NikolayShevyrev/Kicad_EVT_Connector/Datasheets/WhatsApp Image 2021-07-20 at 15.19.37.jpeg

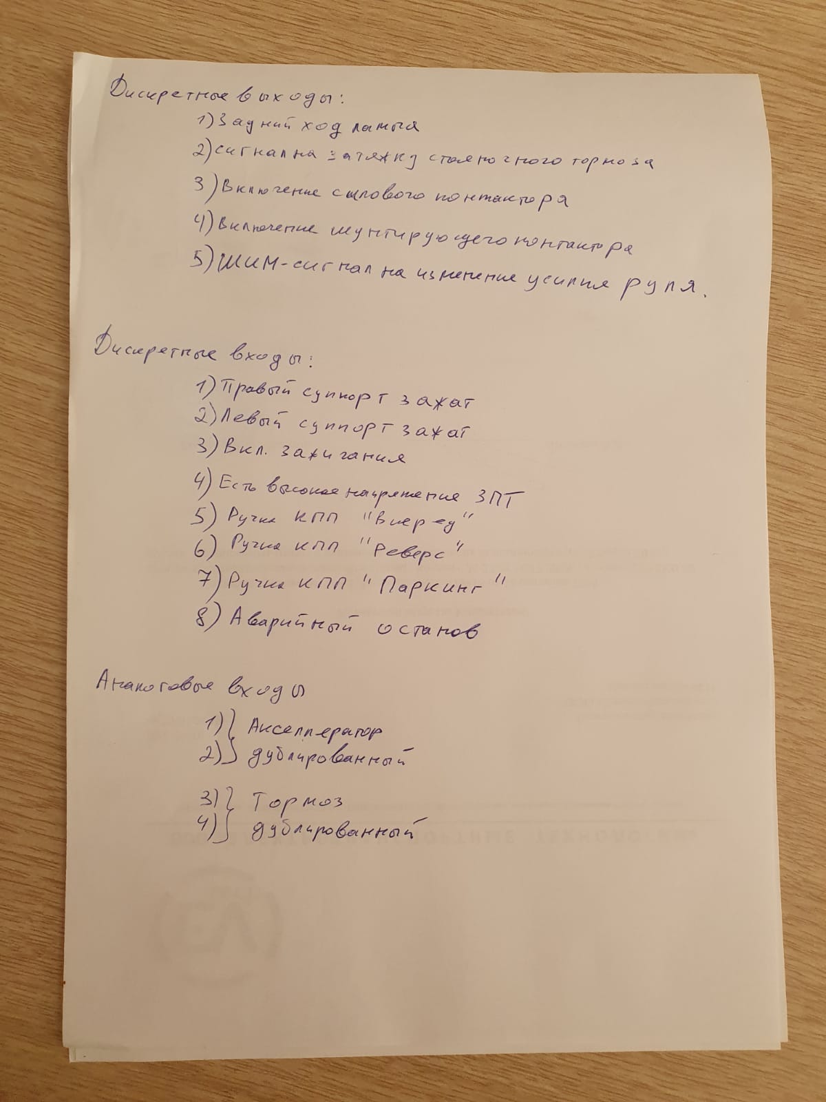
Datasheets/WhatsApp Image 2021-07-20 at 15.19.37.jpeg
