NikolayShevyrev/Kicad_EVT_Connector/Datasheets/WhatsApp Image 2021-07-19 at 15.48.50.jpeg

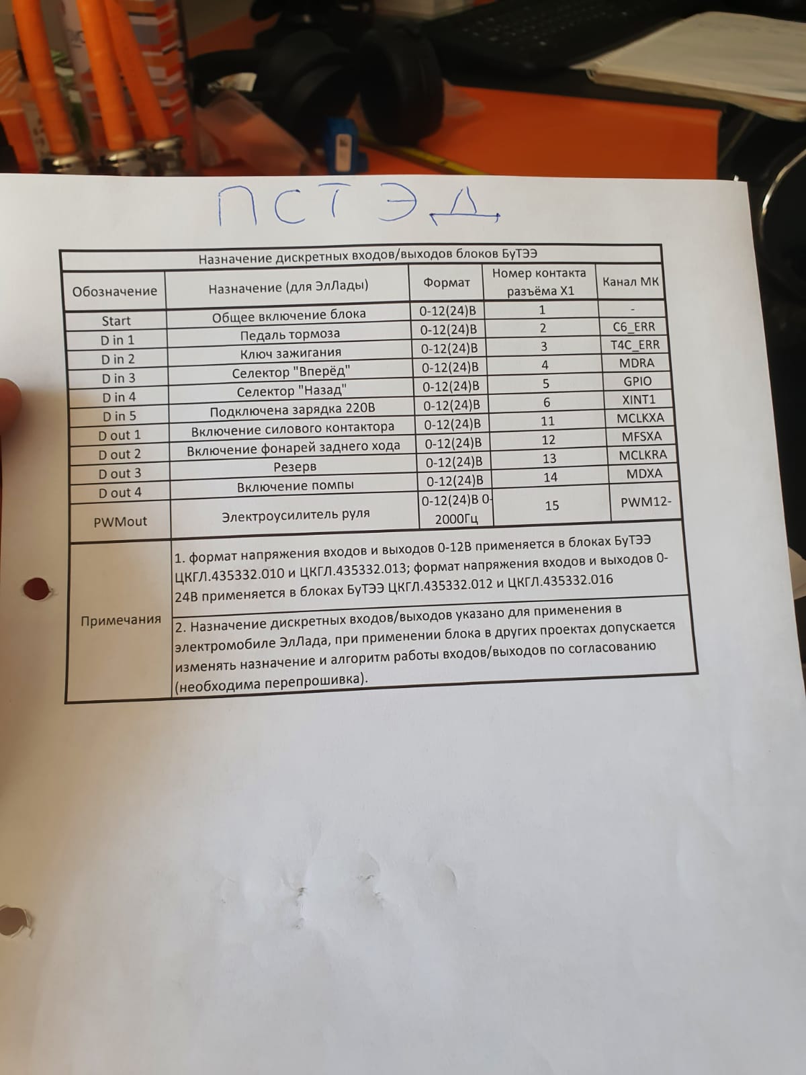
Datasheets/WhatsApp Image 2021-07-19 at 15.48.50.jpeg
