NikolayShevyrev/Kicad_EVT_Connector/Datasheets/WhatsApp Image 2021-07-19 at 15.48.51.jpeg

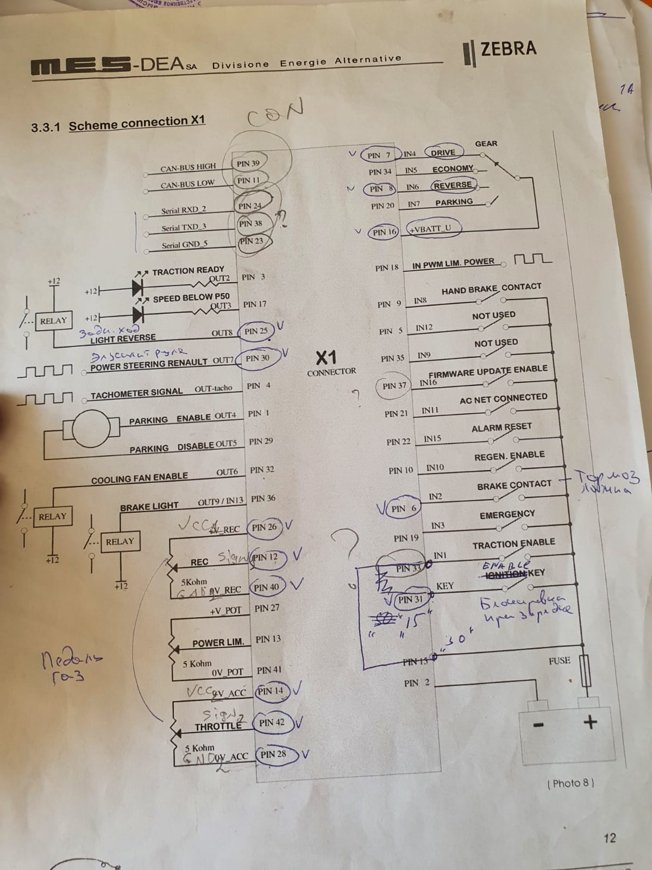
Datasheets/WhatsApp Image 2021-07-19 at 15.48.51.jpeg
