NikolayShevyrev/Kicad_EVT_Connector/Manufacturing/Спецификация.xls

Позиционное обозначение (RefDes)* | Номинал (Value)* | Тип корпуса (Package)* | Кол-во (Quantity)* | Наименование (PartNumber) | Производитель (Manufacturer) | Описание (Description) | Возможная замена/примечание
J1 | 776163-1 | Вилка на плату | 1 | 776163-1
J2 J5 | 43045-1000 | Вилка на плату 3 мм 2x5 | 2 | 43045-1000
J3 J4 | 43045-0800 | Вилка на плату 3 мм 2x4 | 2 | 43045-0800
