NikolayShevyrev/Kicad_EVT_Connector/Manufacturing/Connector_RevB.pdf

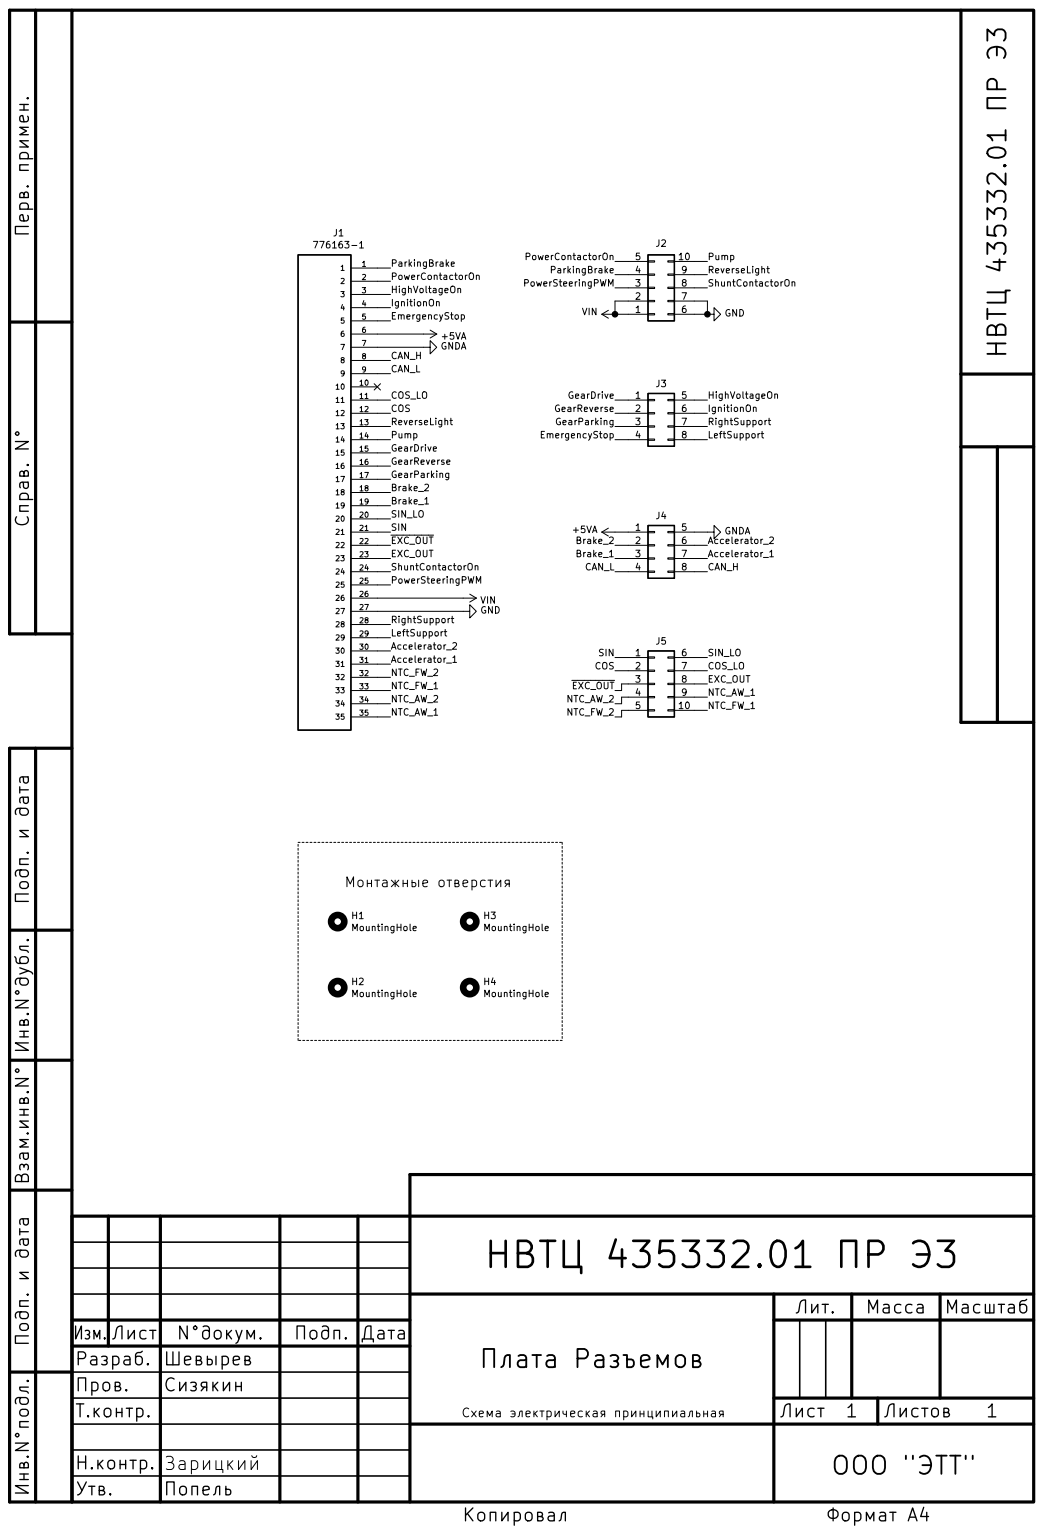
[picture p5: page 1]
