NikolayShevyrev/Kicad_EVT_Connector/Manufacturing/Монтажная_Схема.pdf

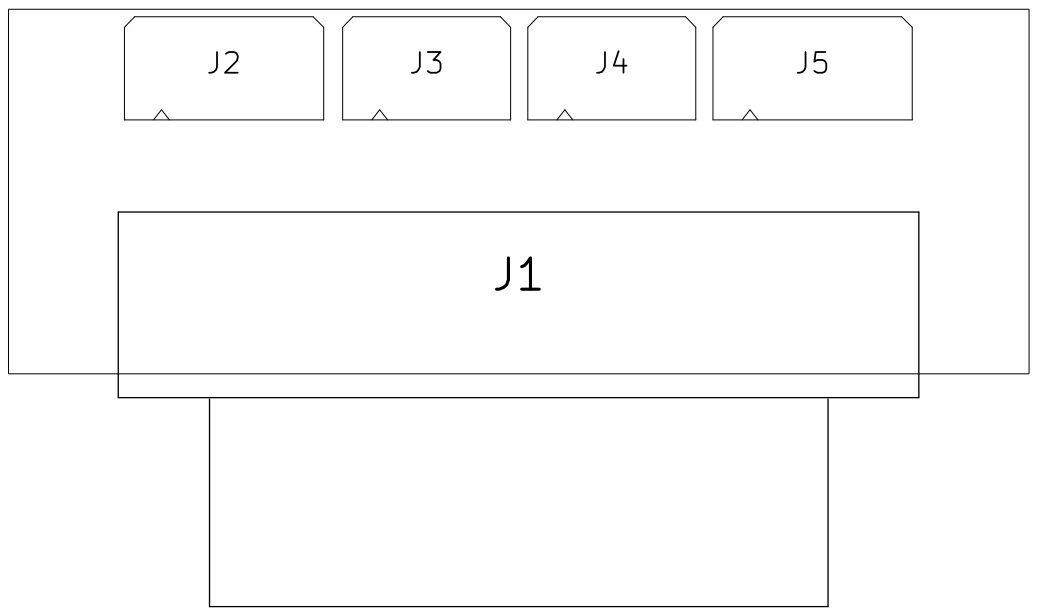
[picture p6: page 1]
