NikolayShevyrev/Kicad_EVT_Connector/Connector.kicad_pcb

## KiCad design Connector.kicad_pcb (2023-03-20)

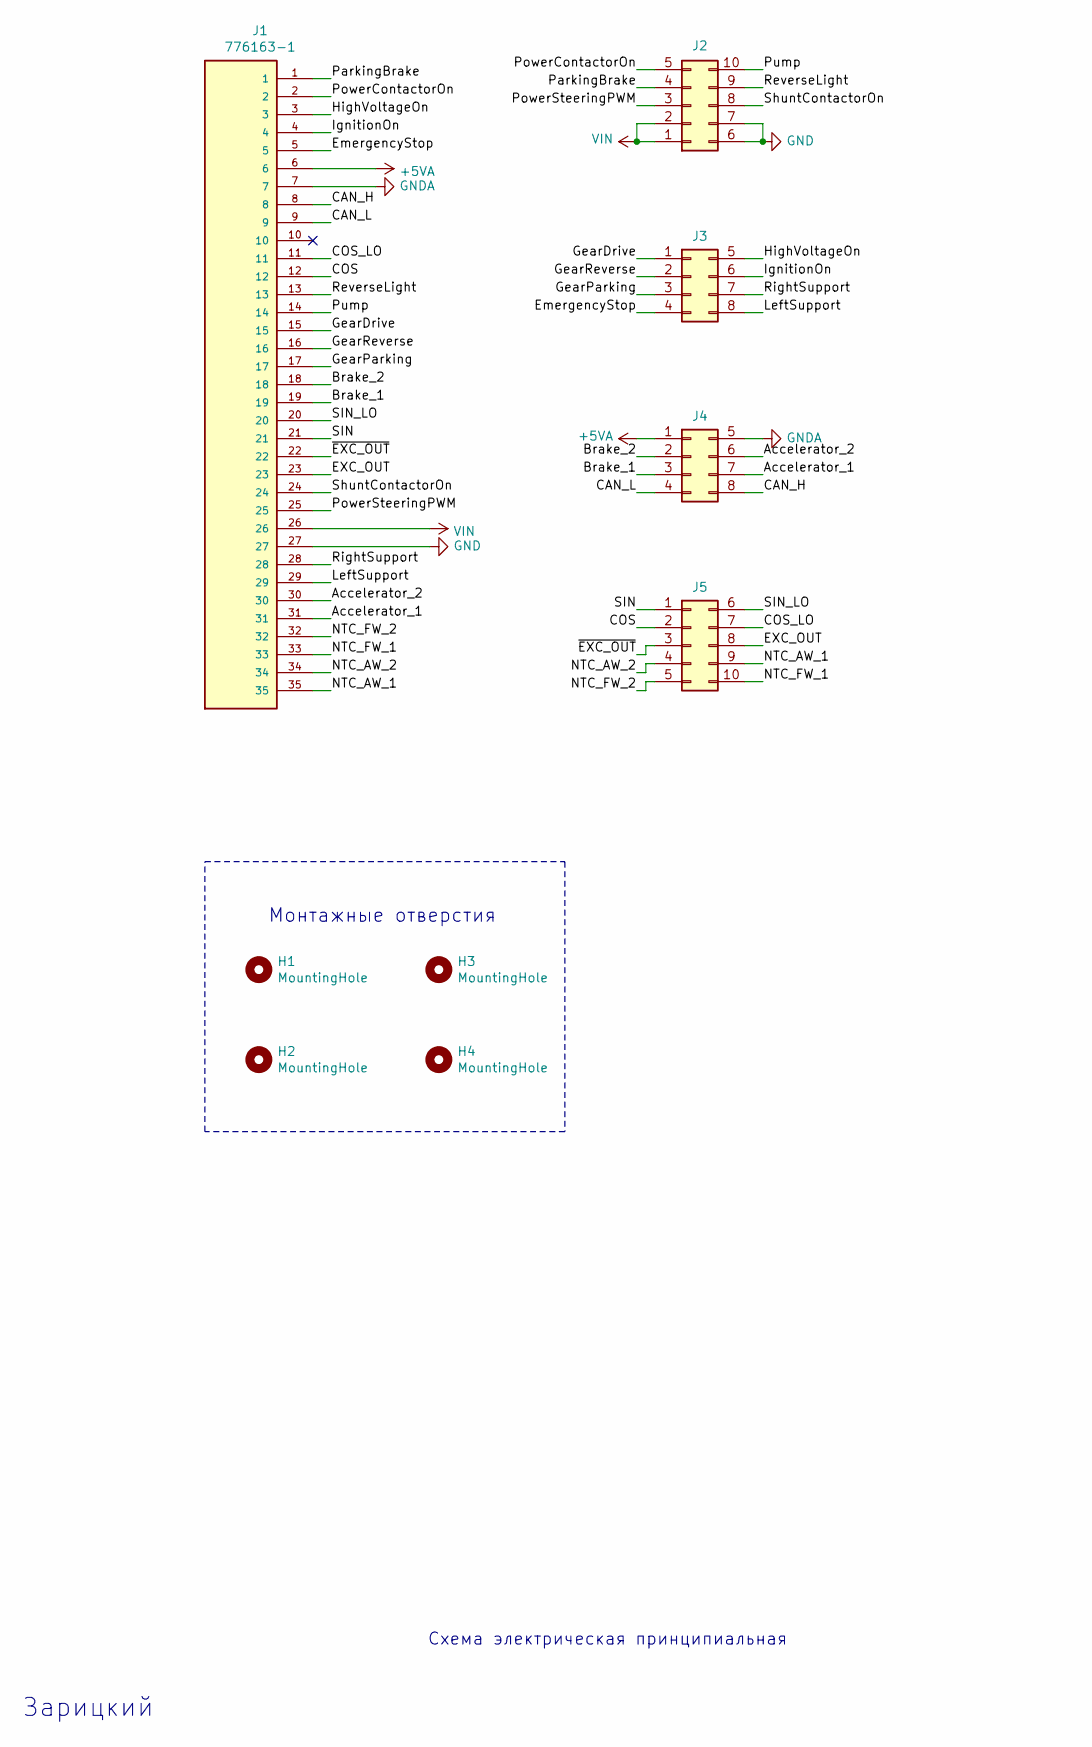
[picture p7: schematic Connector.sch, Плата Разъемов]

Parts:
H1, H2, H3, H4: MountingHole; MountingHole_4.5mm
J1: 776163-1; TE_776163-1
J2, J5: Conn_02x05_Top_Bottom; Molex_Micro-Fit_3.0_43045-1000_2x05_P3.00mm_Horizontal
J3, J4: Conn_02x04_Top_Bottom; Molex_Micro-Fit_3.0_43045-0800_2x04_P3.00mm_Horizontal

Connections:
+5VA: J1.6, J4.1
/Accelerator_1: J1.31, J4.7
/Accelerator_2: J1.30, J4.6
/Brake_1: J1.19, J4.3
/Brake_2: J1.18, J4.2
/CAN_H: J1.8, J4.8
/CAN_L: J1.9, J4.4
/COS: J1.12, J5.2
/COS_LO: J1.11, J5.7
/EXC_OUT: J1.23, J5.8
/EmergencyStop: J1.5, J3.4
/GearDrive: J1.15, J3.1
/GearParking: J1.17, J3.3
/GearReverse: J1.16, J3.2
/HighVoltageOn: J1.3, J3.5
/IgnitionOn: J1.4, J3.6
/LeftSupport: J1.29, J3.8
/NTC_AW_1: J1.35, J5.9
/NTC_AW_2: J1.34, J5.4
/NTC_FW_1: J1.33, J5.10
/NTC_FW_2: J1.32, J5.5
/ParkingBrake: J1.1, J2.4
/PowerContactorOn: J1.2, J2.5
/PowerSteeringPWM: J1.25, J2.3
/Pump: J1.14, J2.10
/ReverseLight: J1.13, J2.9
/RightSupport: J1.28, J3.7
/SIN: J1.21, J5.1
/SIN_LO: J1.20, J5.6
/ShuntContactorOn: J1.24, J2.8
/~EXC_OUT: J1.22, J5.3
GND: J1.27, J2.6, J2.7
GNDA: J1.7, J4.5
VDD: J1.26, J2.1, J2.2

Notes on the sheet:
Монтажные отверстия
Зарицкий
Схема электрическая принципиальная

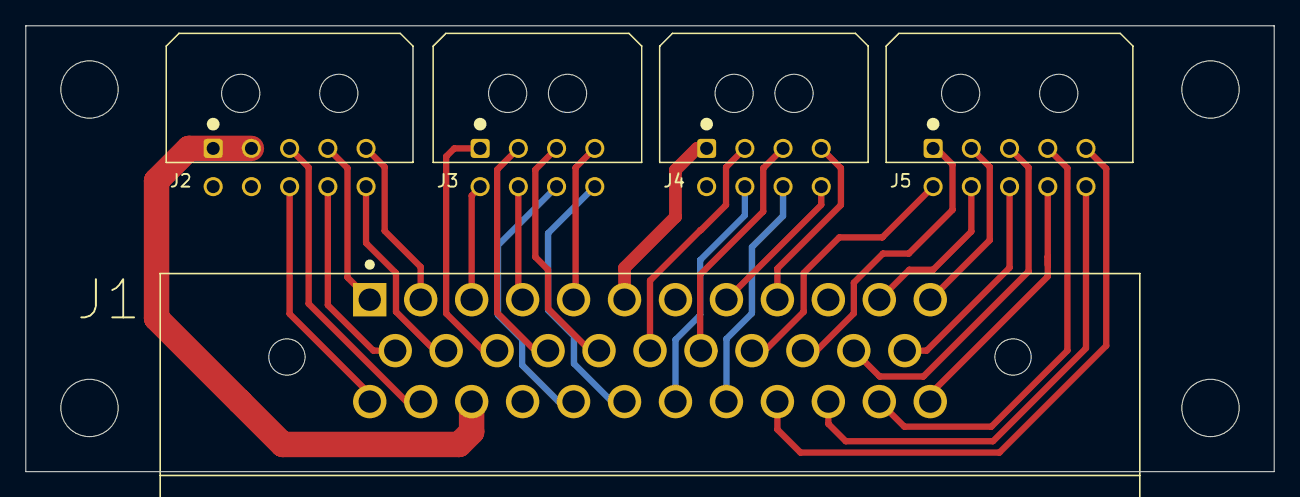
[picture p8: board Connector.kicad_pcb from above]

Board: 2 copper layers, 98.0 x 35.0 mm, 9 parts (0 on the bottom side), 34 nets.
