NikolayShevyrev/Kicad_EVT_Connector/Manufacturing/Распиновка.xlsx

Распиновка сигнального разъема |  | Распиновка энкодера
Номер контакта разъема | Назначение | Цвет провода | Назначение
1 | Стояночный тормоз (Выход) | Красный | +EXC
2 | Вкл силового контактора (Выход) | Черный | -EXC
3 | Есть Высокое Напряжение ЗПТ (Вход) | Белый | SIN
4 | Вкл. Зажигания (Вход) | Синий | SINLO
5 | Аварийный Останов (Вход) | Зеленый | COSLO
6 | +5В (Питание педалей) | Желтый | COS
7 | -5В (Питание педалей)
8 | CAN-BUS HIGH
9 | CAN-BUS LOW
10 | нет соединения
11 | COSLO
12 | COS
13 | Лампа заднего хода (Выход)
14 | Вкл. Помпы (Выход)
15 | Ручка КПП «Вперед» (Вход)
16 | Ручка КПП «Реверс» (Вход)
17 | Ручка КПП «Паркинг» (Вход)
18 | Тормоз 2
19 | Тормоз 1
20 | SINLO
21 | SIN
22 | -EXC
23 | +EXC
24 | Вкл шунтирующего контактора (Выход)
25 | Изменения усилия руля (ШИМ) (Выход)
26 | +Питания(12-24В)
27 | -Питания(12-24В)
28 | Правый Суппорт Зажат (Вход)
29 | Левый Суппорт Зажат (Вход)
30 | Акселератор 2
31 | Акселератор 1
32 | NTC об. Возб. -
33 | NTC об. Возб. +
34 | NTC об. Якоря -
35 | NTC об. Якоря +
