NikolayShevyrev/Kicad_EVT_Connector/(commit log)

2021-07-21 Added pics
    [Connector.sch, IO.xlsx, ВходыВыходы.xlsx]
2021-08-03 Added IO Lables
    [Connector.sch]
2021-08-06 Lables revised
    [Connector.sch, IO.xlsx]
2021-08-16 Added PCB Outline
    [Connector.kicad_pcb, Connector.sch]
2021-08-19 Added Connector PinOut and PCB layout
    [Connector.kicad_pcb, Connector.sch]
2021-08-20 Added Gerbers
    [Connector.csv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]
2021-08-23 Schematic: RevA, PCB: RevA, BOM: V1 RevA
    [Connector.kicad_pcb]
2021-09-13 Added connector pinout
    [Connector.sch, IO.xlsx]
2021-10-06 Rev A, New logo
    [Connector-B_Cu.gbr, Connector-B_Mask.gbr, Connector-B_SilkS.gbr, Connector-Edge_Cuts.gbr, Connector-F_Cu.gbr, Connector-F_Mask.gbr, Connector-F_SilkS.gbr, Connector.drl]
2022-04-29 Added bom and schematic
    [Connector.csv, Connector.kicad_pcb, Connector.sch]
2022-05-11 Added rd_converter inputs/outputs
    [Connector.kicad_pcb, Connector.sch]
